wolfgangfriedrich/P42Display/Design/ver3/P42_Display_Shield_rev3_SCH.png

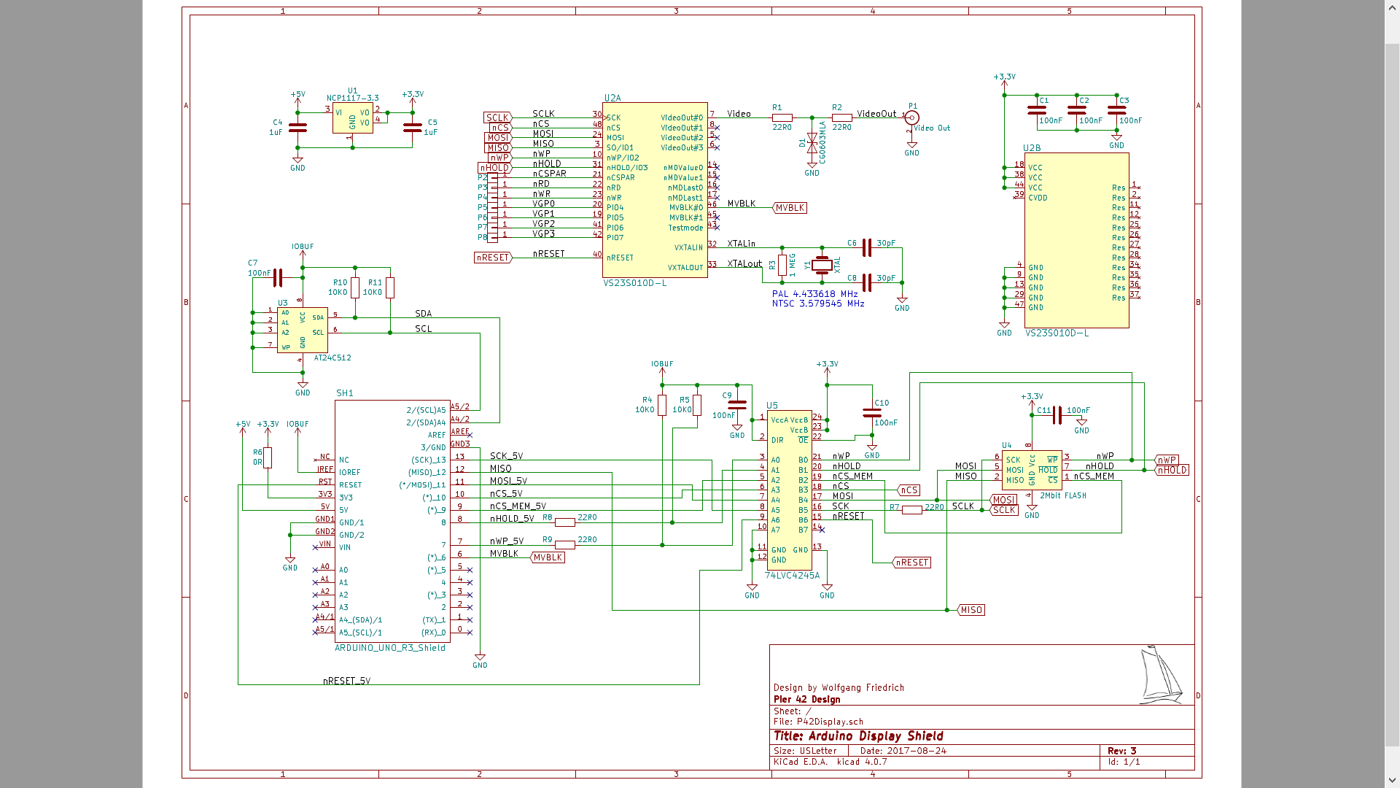
Design/ver3/P42_Display_Shield_rev3_SCH.png
