wolfgangfriedrich/P42Display/Design/ver3/P42Display_rev3_Assembly.xlsx

Name: |  | P42Ddisplay | Rev 3
Date: |  | 2017-11-07 20:05
Tool: |  | Eeschema 4.0.7 |  | Elecrow free components
 |  |  |  | Do not quote/populate
Component Count: |  |  | 30
Collated Components:
Item | Qty | Reference(s) | Value | Footprint | BOM Description | BOM2 | Mfr1 | Mfr1PN | Mfr2 | Mfr2PN | Note
1 | 7 | C1, C2, C3, C7, C9, C10, C11 | 100nF | Capacitors_SMD:C_0603 | Cap, 100nF, +10%, X7R, 0603 |  | generic | na
2 | 2 | C4, C5 | 1uF | Capacitors_SMD:C_0603 | Cap, 1uF, +10%, X7R, 0603 |  | generic | na
3 | 2 | C6, C8 | 30pF | Capacitors_SMD:C_0603 | Cap Cer, 30pF, +10%, NP0, 0603 |  | generic | na
4 | 1 | D1 | CG0603MLA | Capacitors_SMD:C_0603 | Diode TVS 8V 30A 0603 |  | Bourns | CG0603MLA-5.5ME
5 | 1 | P1 | Video Out | project:CUI_RCJ-01x | CONN RCA JACK MONO 3.2MM R/A |  | CUI | RCJ-014
13 | 5 | R1, R2, R7, R8, R9 | 22R0 | Resistors_SMD:R_0603 | RES, 22R0, 1%, 0.1W, 0603
14 | 1 | R3 | 1 MEG | Resistors_SMD:R_0603 | RES, 1MEG, 1%, 0.125W, 0603
15 | 4 | R4, R5, R10, R11 | 10K0 | Resistors_SMD:R_0603 | RES, 10K0, 1%, 0.1W, 0603
16 | 1 | R6 | 0R | Resistors_SMD:R_0603 | RES, 0R0, 1A, 0603
18 | 1 | U1 | NCP1117-3.3 | TO_SOT_Packages_SMD:SOT-223 | IC REG LDO 3.3V 1A SOT223 |  | Diodes Inc | AZ1117EH-3.3TRG1
19 | 1 | U2 | VS23S010D-L | Housings_QFP:LQFP-48_7x7mm_Pitch0.5mm | IC SPI PARALLEL MEM+VIDEO OUT, TQFP-48 |  | VLSI | VS23S010D-L
20 | 1 | U3 | AT24C512 | SMD_Packages:SOIC-8-N | IC, Memory, I2C, 512Kbit, SO-08 |  | Atmel | AT24CS64-SSHM
21 | 1 | U4 | 2Mbit FLASH | SMD_Packages:SOIC-8-N | IC FLASH 2MBIT 8SOIC |  | Winbond | W25X20CLSNIG
22 | 1 | U5 | 74LVC4245A | Housings_SSOP:TSSOP-24_4.4x7.8mm_Pitch0.65mm | IC TRANSCVR TRI-ST DL 24TSSOP |  | Nexperia | 74LVC4245APW
23 | 1 | Y1 | XTAL | Crystals:Crystal_SMD_HC49-SD | CRYSTAL 3.579545MHZ 18PF NTSC HC-49-SMD | CRYSTAL 4.433619MHZ 18PF PAL HC49-SMD | Abracon | ABLS-3.579545MHZ-D-4-T | Abracon | ABLS-4.433619MHZ-B4-T | PAL
 | 30
