wolfgangfriedrich/P42Display/Design/ver3/P42Display_rev3_ASSY.pdf

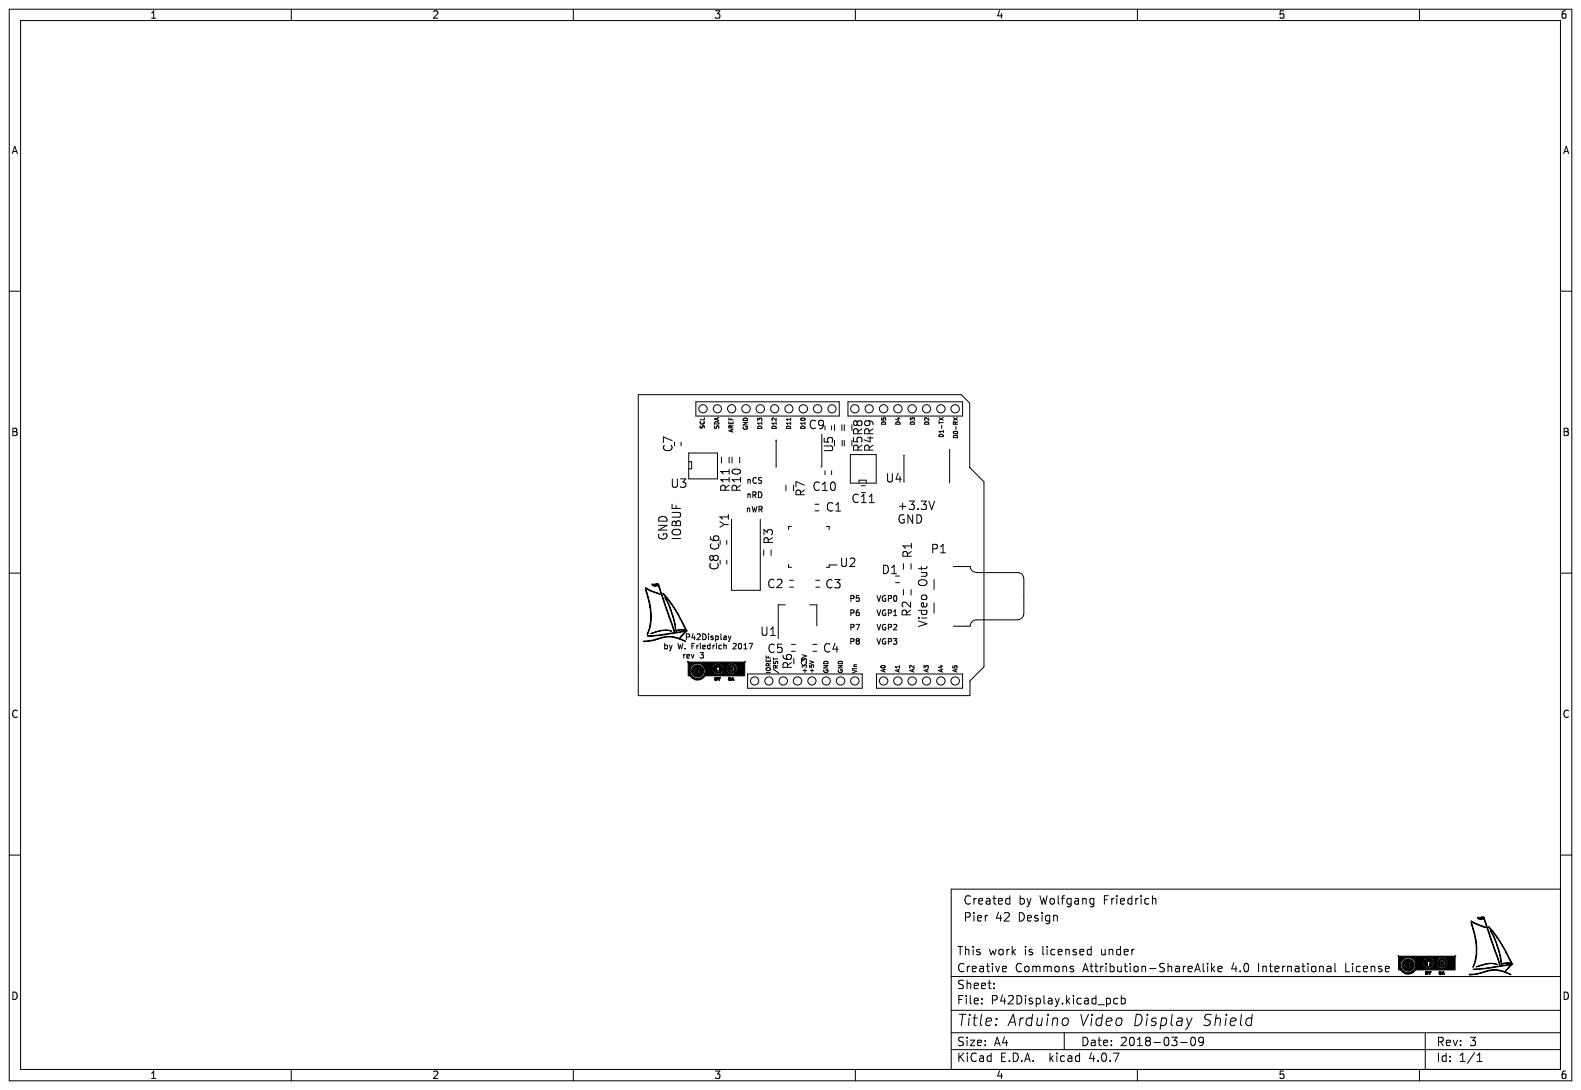
[picture p10: page 1]
