wolfgangfriedrich/P42Display/Design/ver3/P42Display_rev3_SCH.pdf

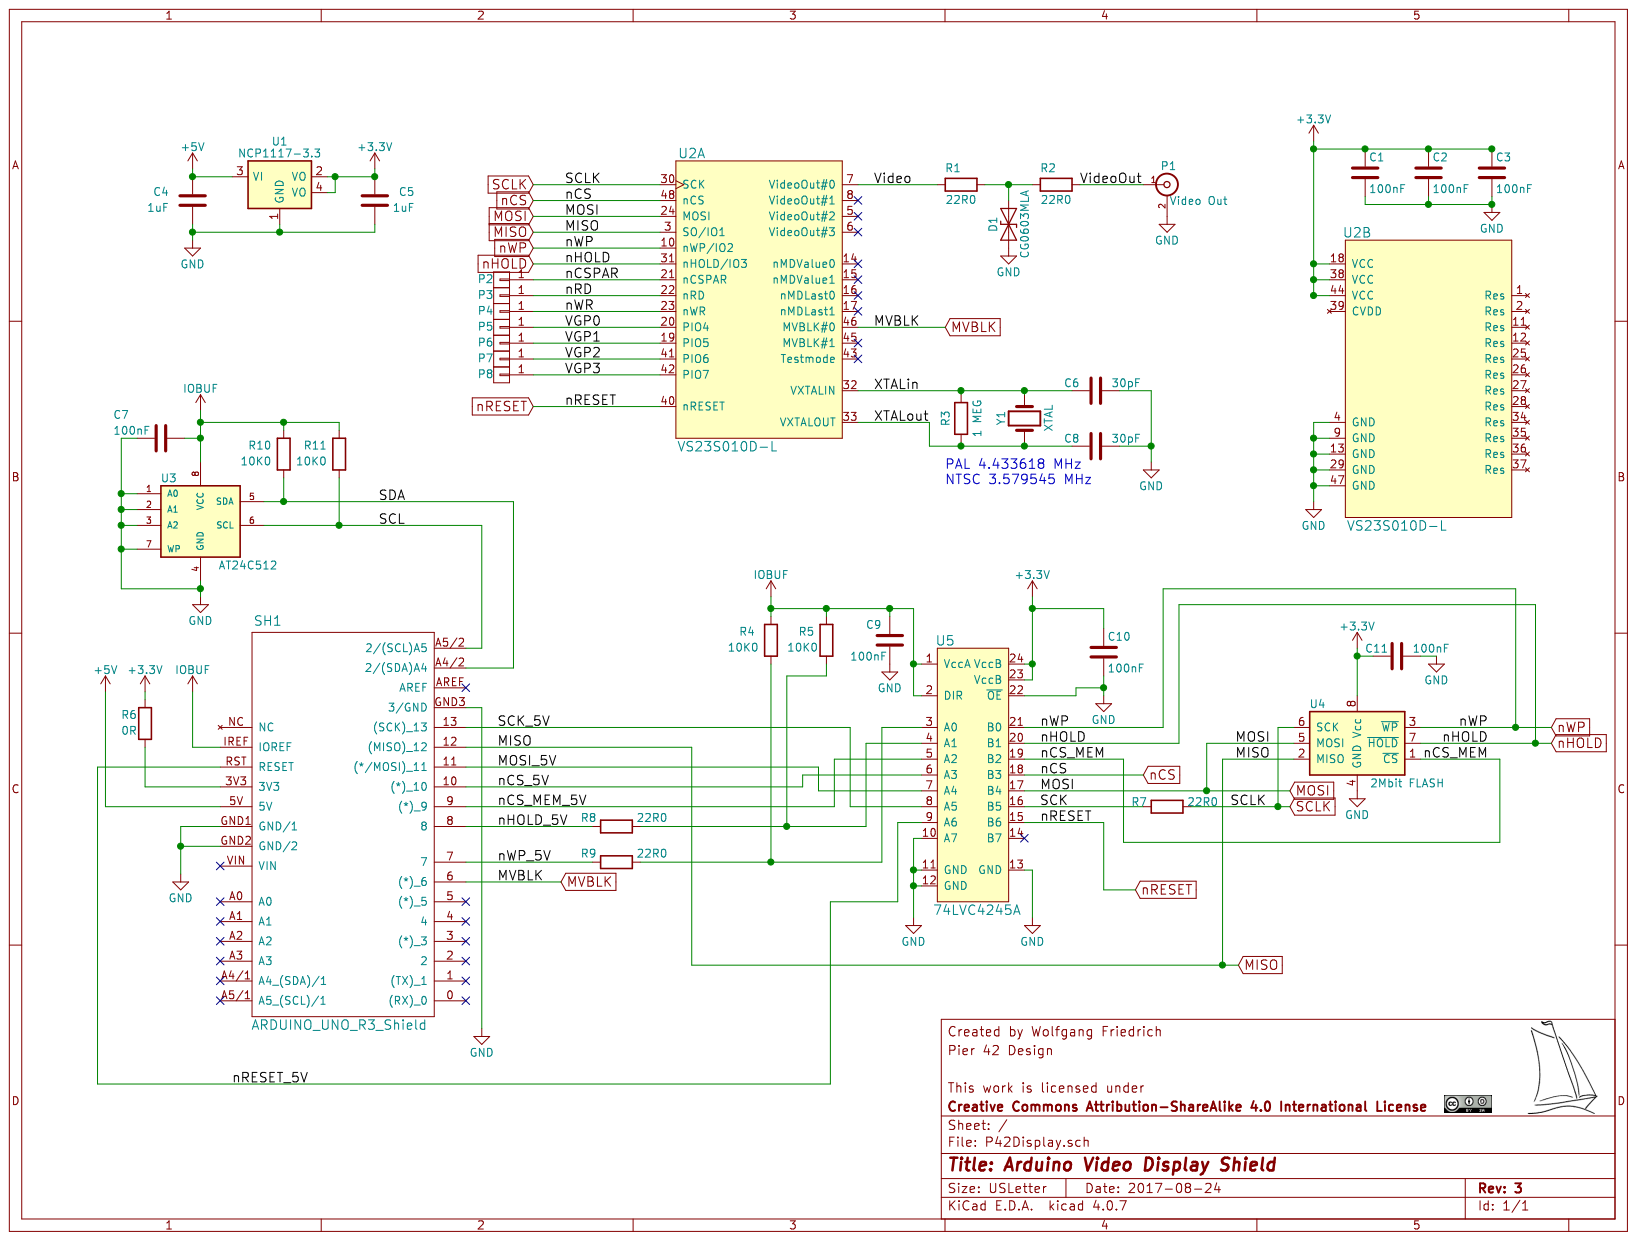
[picture p11: page 1]
