wolfgangfriedrich/P42Display/Design/ver1/P42Display_rev1_sch.pdf

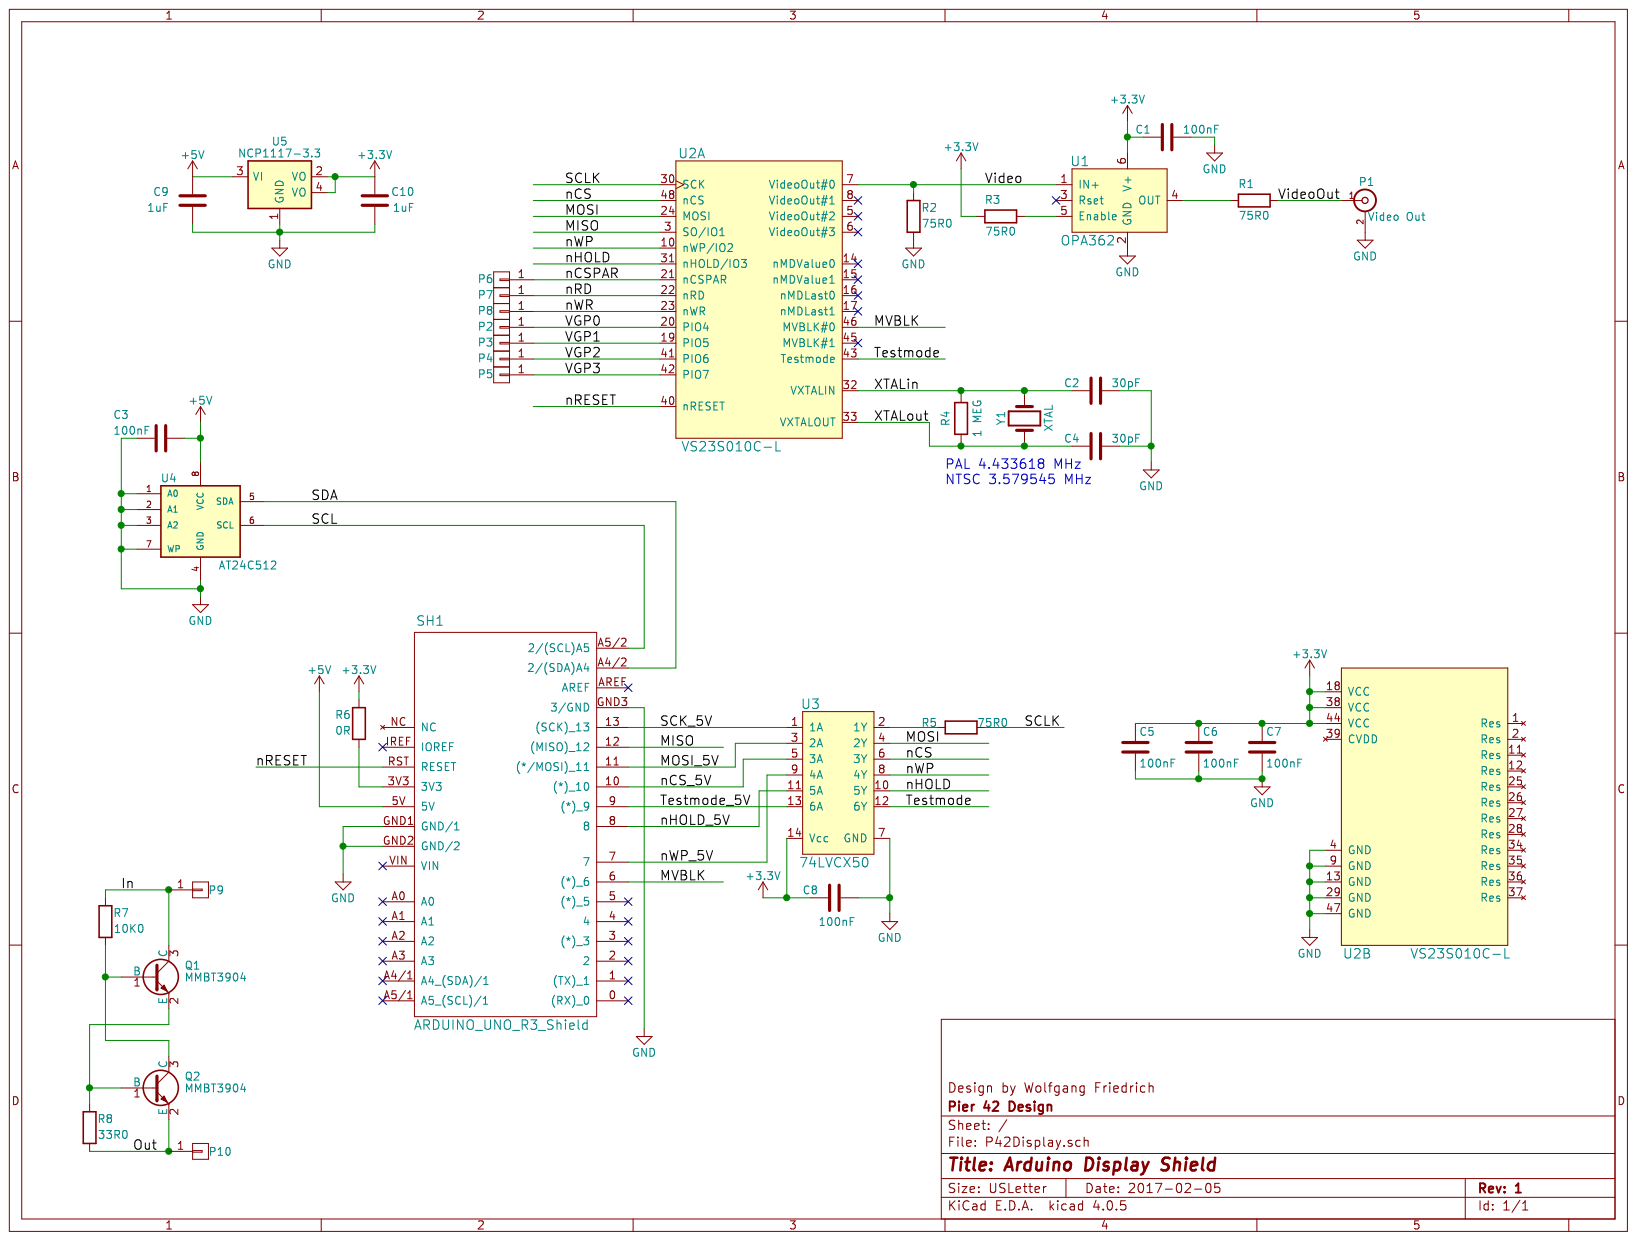
[picture p12: page 1]
