wolfgangfriedrich/P42Display/Design/ver3/P42Display.kicad_pcb

## KiCad design Design/ver3/P42Display.kicad_pcb (2018-03-10)

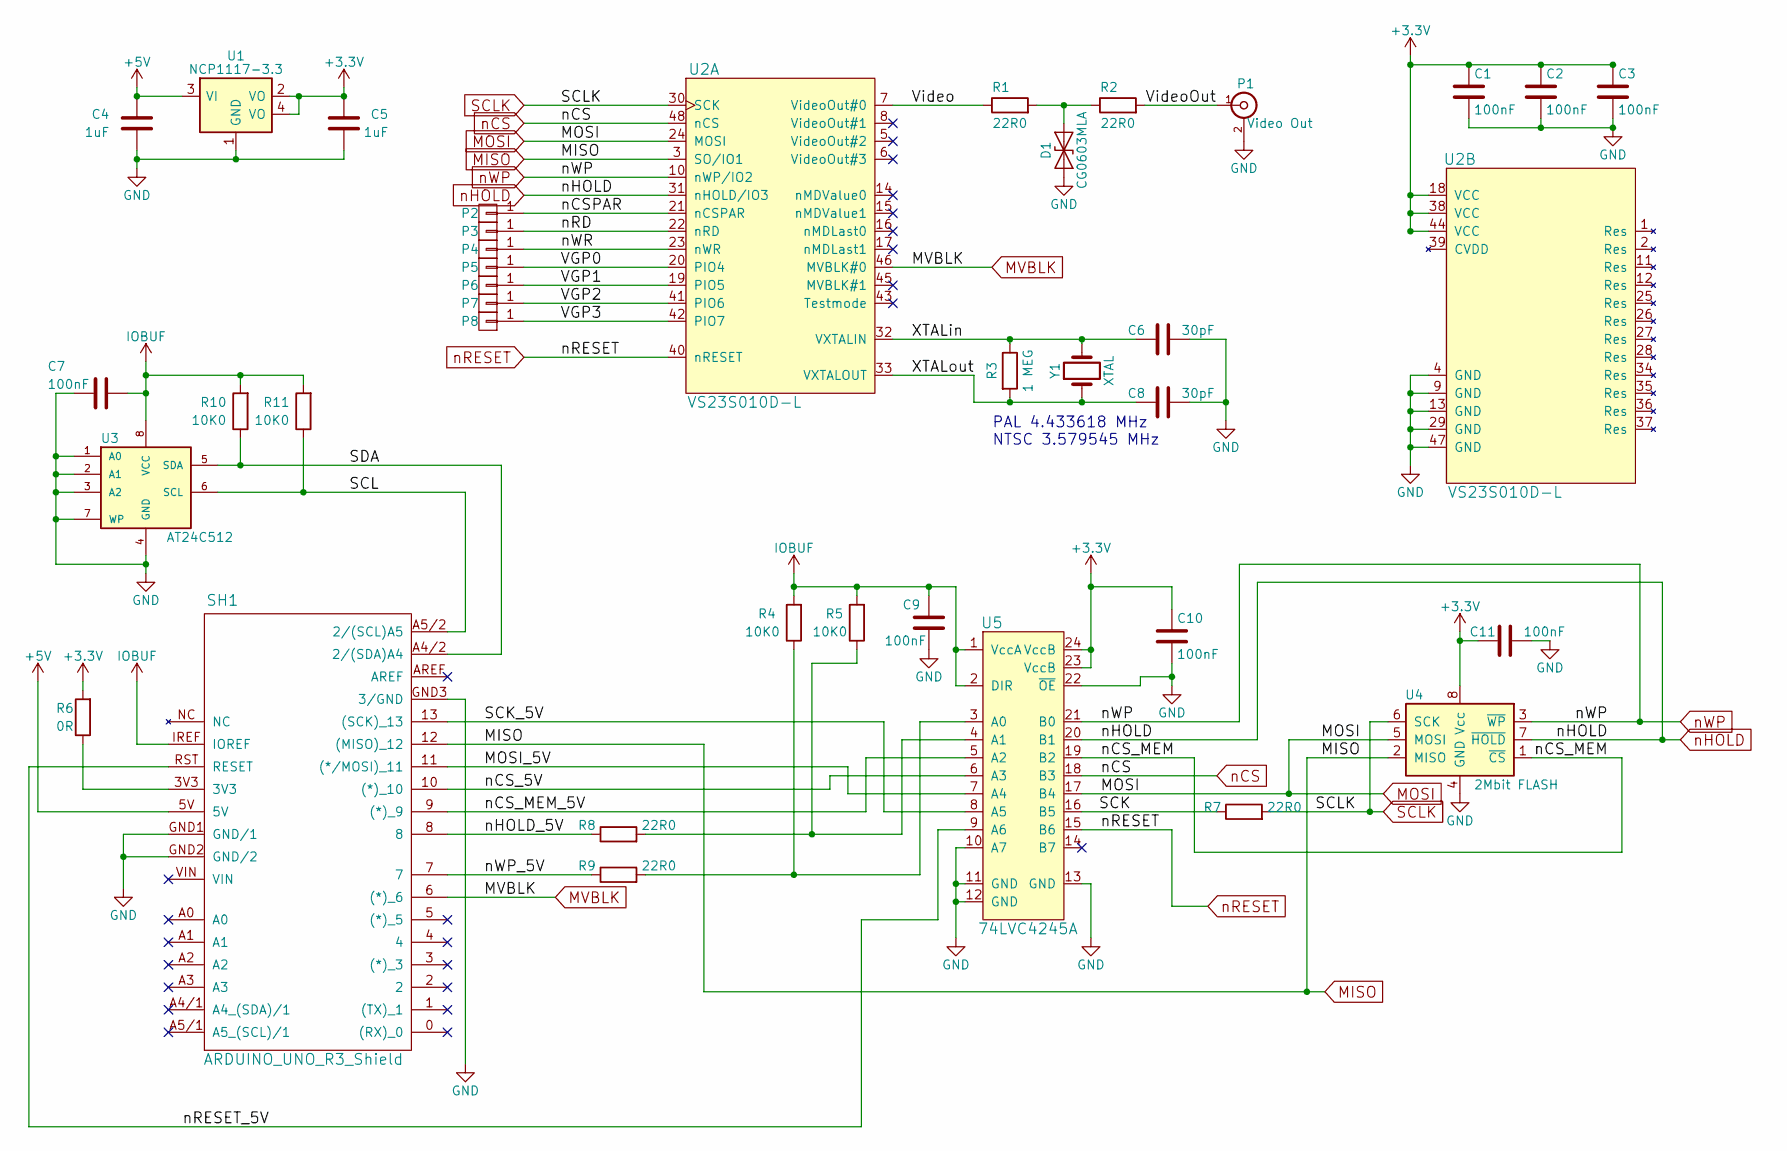
[picture p13: schematic P42Display.sch, Arduino Video Display Shield]

Parts:
C1, C2, C3, C7, C9, C10, C11: 100nF; C_0603; Mfr1PN na
C4, C5: 1uF; C_0603; Mfr1PN na
C6, C8: 30pF; C_0603; Mfr1PN na
D1: CG0603MLA; C_0603; Mfr1PN CG0603MLA-5.5ME
P1: Video Out; CUI_RCJ-01x; Mfr1PN RCJ-014
P2: nCS; Measurement_Point_Round-TH_Small
P3: nRD; Measurement_Point_Round-TH_Small
P4: nWR; Measurement_Point_Round-TH_Small
P5: VGP0; Measurement_Point_Round-TH_Small
P6: VGP1; Measurement_Point_Round-TH_Small
P7: VGP2; Measurement_Point_Round-TH_Small
P8: VGP3; Measurement_Point_Round-TH_Small
R1, R2, R7, R8, R9: 22R0; R_0603
R3: 1 MEG; R_0603
R4, R5, R10, R11: 10K0; R_0603
R6: 0R; R_0603
SH1: ARDUINO_UNO_R3_Shield; ARDUINO_as_UNO_R3_CONTOUR
U1: NCP1117-3.3; SOT-223; Mfr1PN AZ1117EH-3.3TRG1
U2: VS23S010D-L; LQFP-48_7x7mm_Pitch0.5mm; Mfr1PN VS23S010D-L
U3: AT24C512; SOIC-8-N; Mfr1PN AT24CS64-SSHM
U4: 2Mbit FLASH; SOIC-8-N; Mfr1PN W25X20CLSNIG
U5: 74LVC4245A; TSSOP-24_4.4x7.8mm_Pitch0.65mm; Mfr1PN 74LVC4245APW
Y1: XTAL; Crystal_SMD_HC49-SD; Mfr1PN ABLS-3.579545MHZ-D-4-T

Connections:
+3V3: C1.1, C2.1, C3.1, C5.2, C10.1, C11.2, R6.2, U1.2 (VO), U1.4 (VO), U2.18 (VCC), U2.38 (VCC), U2.44 (VCC), U4.8 (Vcc), U5.23 (VccB), U5.24 (VccB)
+5V: C4.2, SH1.5V, U1.3 (VI)
/MOSI_5V: SH1.11 ((*/MOSI)_11), U5.7 (A4)
/SCK: R7.1, U5.16 (B5)
/SCK_5V: SH1.13 ((SCK)_13), U5.8 (A5)
/SCL: R11.1, SH1.A5/2 (2/(SCL)A5), U3.6 (SCL)
/SDA: R10.1, SH1.A4/2 (2/(SDA)A4), U3.5 (SDA)
/VGP0: P5.1, U2.20 (PIO4)
/VGP1: P6.1, U2.19 (PIO5)
/VGP2: P7.1, U2.41 (PIO6)
/VGP3: P8.1, U2.42 (PIO7)
/Video: R1.1, U2.7 (VideoOut#0)
/VideoOut: P1.1 (In), R2.2
/XTALin: C6.2, R3.1, U2.32 (VXTALIN), Y1.2
/XTALout: C8.2, R3.2, U2.33 (VXTALOUT), Y1.1
/nCSPAR: P2.1, U2.21 (nCSPAR)
/nCS_5V: SH1.10 ((*)_10), U5.6 (A3)
/nCS_MEM: U4.1 (~CS), U5.19 (B2)
/nCS_MEM_5V: SH1.9 ((*)_9), U5.5 (A2)
/nHOLD_5V: R8.1, SH1.8
/nRD: P3.1, U2.22 (nRD)
/nRESET_5V: SH1.RST (RESET), U5.9 (A6)
/nWP_5V: R9.1, SH1.7
/nWR: P4.1, U2.23 (nWR)
GND: C1.2, C2.2, C3.2, C4.1, C5.1, C6.1, C7.2, C8.1, C9.2, C10.2, C11.1, D1.1 (A1), P1.2 (Ext), SH1.GND1 (GND/1), SH1.GND2 (GND/2), SH1.GND3 (3/GND), U1.1 (GND), U2.4 (GND), U2.9 (GND), U2.13 (GND), U2.29 (GND), U2.47 (GND), U3.1 (A0), U3.2 (A1), U3.3 (A2), U3.4 (GND), U3.7 (WP), U4.4 (GND), U5.10 (A7), U5.11 (GND), U5.12 (GND), U5.13 (GND), U5.22 (~OE)
IOBUF: C7.1, C9.1, R4.2, R5.2, R10.2, R11.2, SH1.IREF (IOREF), U3.8 (VCC), U5.1 (VccA), U5.2 (DIR)
MISO: SH1.12 ((MISO)_12), U2.3 (SO/IO1), U4.2 (MISO)
MOSI: U2.24 (MOSI), U4.5 (MOSI), U5.17 (B4)
MVBLK: SH1.6 ((*)_6), U2.46 (MVBLK#0)
unnamed: D1.2 (A2), R1.2, R2.1
unnamed: R4.1, R9.2, U5.3 (A0)
unnamed: R5.1, R8.2, U5.4 (A1)
unnamed: R6.1, SH1.3V3
SCLK: R7.2, U2.30 (SCK), U4.6 (SCK)
nCS: U2.48 (nCS), U5.18 (B3)
nHOLD: U2.31 (nHOLD/IO3), U4.7 (~HOLD), U5.20 (B1)
nRESET: U2.40 (nRESET), U5.15 (B6)
nWP: U2.10 (nWP/IO2), U4.3 (~WP), U5.21 (B0)

Notes on the sheet:
PAL 4.433618 MHz NTSC 3.579545 MHz

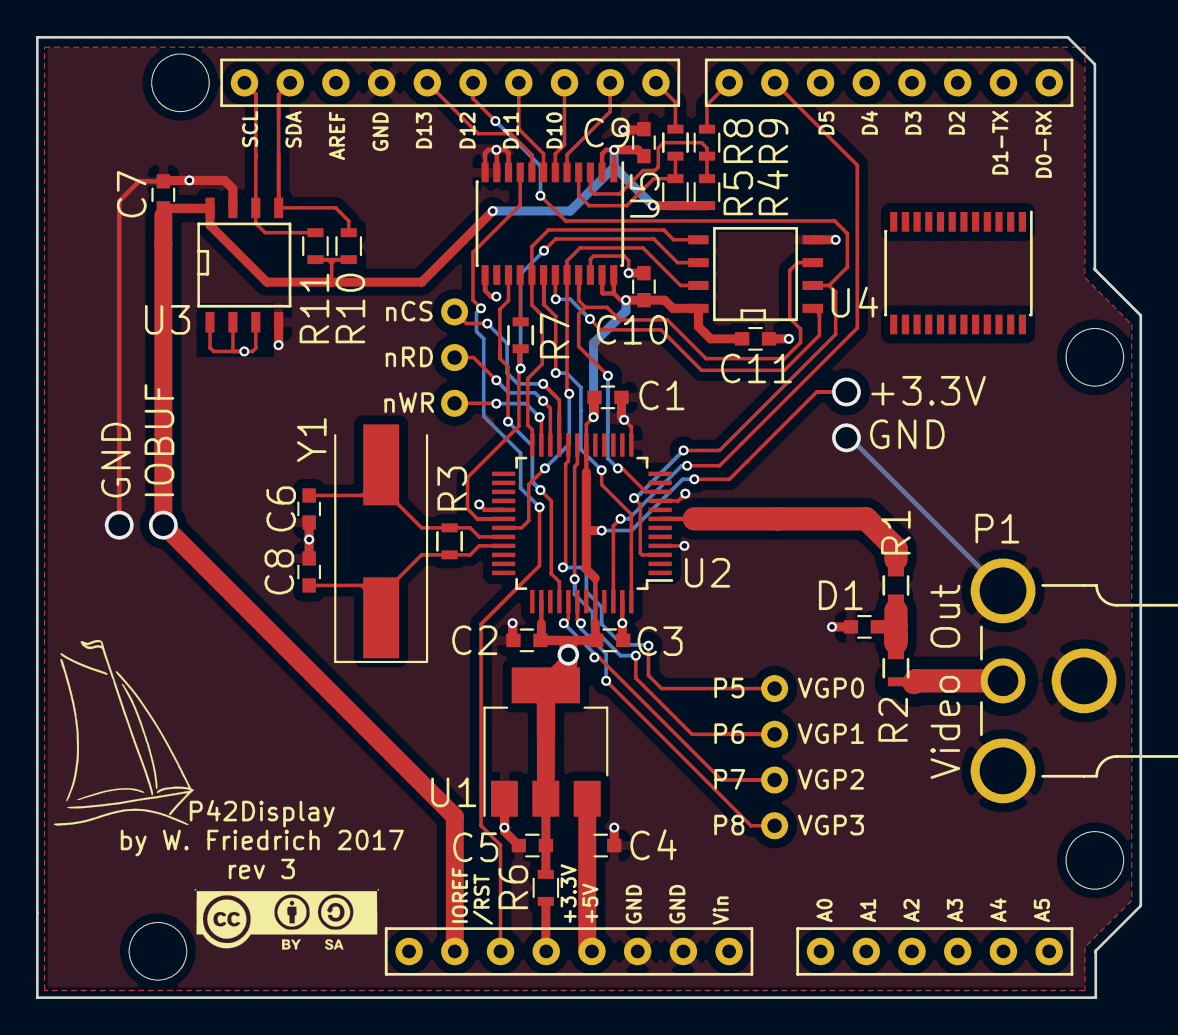
[picture p14: board P42Display.kicad_pcb from above]

Board: 2 copper layers, 61.3 x 53.3 mm, 38 parts (0 on the bottom side), 38 nets.
