wolfgangfriedrich/P42Display/Code/P42_charmem/hack8x8.h

// 
//  Font data for Hack 8pt
// 

// Character bitmaps for Hack 8pt
const byte hack_8ptBitmaps[] = 
{
	// @0 '!' (2 pixels wide)
	0x00, //   
	0x40, //  #
	0x40, //  #
	0x40, //  #
	0x40, //  #
	0x00, //   
	0xC0, // ##
	0x00, //   

	// @12 '"' (3 pixels wide)
	0x00, //    
	0xA0, // # #
	0xA0, // # #
	0x00, //    
	0x00, //    
	0x00, //    
	0x00, //    
	0x00, //    

	// @24 '#' (7 pixels wide)
	0x24, //   #  # 
	0x7E, //  ######
	0x28, //   # #  
	0x28, //   # #  
	0xFC, // ###### 
	0x50, //  # #   
	0x50, //  # #   
	0x00, //        

	// @36 '$' (5 pixels wide)
	0x20, //   #  
	0x70, //  ### 
	0xA0, // # #  
	0x70, //  ### 
	0x28, //   # #
	0xF0, // #### 
	0x20, //   #  
	0x00, //      

	// @48 '%' (6 pixels wide)
	0x00, //      
	0x60, //  ##   
	0x94, // #  # #
	0x78, //  #### 
	0x6C, //  ## ##
	0x94, // #  # #
	0x0C, //     ##
	0x00, //       

	// @60 '&' (7 pixels wide)
	0x38, //   ###  
	0x40, //  #     
	0x60, //  ##    
	0x52, //  # #  #
	0x8C, // #   ## 
	0xCC, // ##  ## 
	0x76, //  ### ##
	0x00, //        

	// @72 ''' (1 pixels wide)
	0x00, //  
	0x80, // #
	0x80, // #
	0x00, //  
	0x00, //  
	0x00, //  
	0x00, //  
	0x00, //  

	// @84 '(' (2 pixels wide)
	0x00, //   
	0x40, //  #
	0x80, // # 
	0x80, // # 
	0x80, // # 
	0x80, // # 
	0x80, // # 
	0x40, //  #

	// @96 ')' (2 pixels wide)
	0x00, //   
	0x80, // # 
	0x40, //  # 
	0x40, //  #
	0x40, //  #
	0x40, //  #
	0x40, //  # 
	0x80, // # 

	// @108 '*' (5 pixels wide)
	0x00, //      
	0x20, //   #  
	0xA8, // # # #
	0x70, //  ### 
	0xA8, // # # #
	0x20, //   #  
	0x00, //      
	0x00, //      

	// @120 '+' (6 pixels wide)
	0x00, //       
	0x10, //    #  
	0x10, //    #  
	0x7C, //  #####
	0x10, //    #  
	0x10, //    #  
	0x00, //       
	0x00, //       

	// @132 ',' (2 pixels wide)
	0x00, //   
	0x00, //   
	0x00, //   
	0x00, //   
	0x00, //   
	0x40, //  #
	0x40, //  #
	0xC0, // ##

	// @144 '-' (5 pixels wide)
	0x00, //      
	0x00, //      
	0x00, //      
	0x00, //      
	0xF8, // #####
	0x00, //      
	0x00, //      
	0x00, //      

	// @156 '.' (2 pixels wide)
	0x00, //   
	0x00, //   
	0x00, //   
	0x00, //   
	0x00, //   
	0x40, //  #
	0xC0, // ##
	0x00, //   

	// @168 '/' (5 pixels wide)
	0x08, //     #
	0x10, //    # 
	0x10, //    # 
	0x20, //   #  
	0x20, //   #  
	0x40, //  #   
	0x40, //  #   
	0x80, // #    

	// @180 '0' (5 pixels wide)
	0x00, //      
	0x70, //  ### 
	0x98, // #  ##
	0xA8, // # # #
	0xA8, // # # #
	0xC8, // ##  #
	0x70, //  ### 
	0x00, //      

	// @192 '1' (5 pixels wide)
	0x00, //      
	0xE0, // ###  
	0x20, //   #  
	0x20, //   #  
	0x20, //   #  
	0x20, //   #  
	0xF8, // #####
	0x00, //      

	// @204 '2' (5 pixels wide)
	0x00, //      
	0x70, //  ### 
	0x88, // #   #
	0x10, //    # 
	0x60, //  ##  
	0x80, // #    
	0xF8, // #####
	0x00, //      

	// @216 '3' (5 pixels wide)
	0x00, //      
	0xF0, // #### 
	0x18, //    ##
	0x60, //  ##  
	0x18, //    ##
	0x08, //     #
	0xF0, // #### 
	0x00, //      

	// @228 '4' (5 pixels wide)
	0x00, //      
	0x10, //    # 
	0x30, //   ## 
	0x50, //  # # 
	0x90, // #  # 
	0xF8, // #####
	0x10, //    # 
	0x00, //      

	// @240 '5' (5 pixels wide)
	0x00, //      
	0xF0, // #### 
	0x80, // #    
	0xF0, // #### 
	0x08, //     #
	0x08, //     #
	0xF0, // #### 
	0x00, //      

	// @252 '6' (5 pixels wide)
	0x00, //      
	0x70, //  ### 
	0x80, // #    
	0xF0, // #### 
	0x88, // #   #
	0x88, // #   #
	0x70, //  ### 
	0x00, //      

	// @264 '7' (5 pixels wide)
	0x00, //      
	0xF8, // #####
	0x10, //    # 
	0x10, //    # 
	0x20, //   #  
	0x40, //  #   
	0x40, //  #   
	0x00, //      

	// @276 '8' (5 pixels wide)
	0x00, //      
	0x70, //  ### 
	0x88, // #   #
	0x70, //  ### 
	0x88, // #   #
	0x88, // #   #
	0x70, //  ### 
	0x00, //      

	// @288 '9' (5 pixels wide)
	0x00, //      
	0x70, //  ### 
	0x88, // #   #
	0x98, // #  ##
	0x68, //  ## #
	0x08, //     #
	0xF0, // #### 
	0x00, //      

	// @300 ':' (2 pixels wide)
	0x00, //   
	0x00, //   
	0xC0, // ##
	0x40, //  #
	0x00, //   
	0xC0, // ##
	0x40, //  #
	0x00, //   

	// @312 ';' (2 pixels wide)
	0x00, //   
	0x00, //   
	0x40, //  #
	0xC0, // ##
	0x00, //   
	0x40, //  #
	0x40, //  #
	0xC0, // ##

	// @324 '<' (6 pixels wide)
	0x00, //       
	0x00, //       
	0x0C, //     ##
	0x30, //   ##  
	0xC0, // ##    
	0x30, //   ##  
	0x0C, //     ##
	0x00, //       

	// @336 '=' (6 pixels wide)
	0x00, //       
	0x00, //       
	0x00, //       
	0xFC, // ######
	0x00, //       
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
	0xE0, // ###  
	0x20, //   #  
	0x20, //   #  
	0x18, //    ##
	0x20, //   #  
	0x20, //   #  
	0x20, //   #  
	0xE0, // ###  

	// @1116 '~' (6 pixels wide)
	0x00, //       
	0x00, //       
	0x00, //       
	0x24, //   #  #
	0x54, //  # # #
	0x88, // #   #
	0x00, //       
	0x00, //       
};
