wolfgangfriedrich/P42Display/Code/P42Display_Memtest/ball_frames.h

// Image data for spinning Amiga Ball Demo
// red   0x24
// white 0x0D
// black 0x00
const static byte boingball_X PROGMEM = 32;
const static byte boingball_Y PROGMEM = 32;
const static byte boingball[] PROGMEM = 
{
// frame 0
0x00, 0x00, 0x00, 0x00, 0x00, 0x00, 0x00, 0x00, 0x00, 0x00, 0x00, 0x00, 0x00, 0x00, 0x00, 0x00, 0x00, 0x00, 0x00, 0x00, 0x00, 0x00, 0x00, 0x00, 0x00, 0x00, 0x00, 0x00, 0x00, 0x00, 0x00, 0x00, 
0x00, 0x00, 0x00, 0x00, 0x00, 0x00, 0x00, 0x00, 0x00, 0x00, 0x00, 0x24, 0x24, 0x0D, 0x0D, 0x0D, 0x0D, 0x24, 0x24, 0x24, 0x24, 0x0D, 0x00, 0x00, 0x00, 0x00, 0x00, 0x00, 0x00, 0x00, 0x00, 0x00, 
0x00, 0x00, 0x00, 0x00, 0x00, 0x00, 0x00, 0x00, 0x24, 0x0D, 0x0D, 0x0D, 0x24, 0x24, 0x24, 0x24, 0x24, 0x0D, 0x24, 0x24, 0x24, 0x24, 0x0D, 0x0D, 0x00, 0x00, 0x00, 0x00, 0x00, 0x00, 0x00, 0x00, 
0x00, 0x00, 0x00, 0x00, 0x00, 0x00, 0x00, 0x0D, 0x0D, 0x0D, 0x0D, 0x24, 0x24, 0x24, 0x24, 0x24, 0x0D, 0x0D, 0x0D, 0x0D, 0x0D, 0x0D, 0x0D, 0x0D, 0x0D, 0x24, 0x00, 0x00, 0x00, 0x00, 0x00, 0x00, 
0x00, 0x00, 0x00, 0x00, 0x00, 0x00, 0x0D, 0x0D, 0x0D, 0x0D, 0x24, 0x24, 0x24, 0x24, 0x24, 0x24, 0x0D, 0x0D, 0x0D, 0x0D, 0x0D, 0x0D, 0x24, 0x24, 0x24, 0x0D, 0x24, 0x00, 0x00, 0x00, 0x00, 0x00, 
0x00, 0x00, 0x00, 0x00, 0x00, 0x0D, 0x0D, 0x0D, 0x0D, 0x24, 0x24, 0x24, 0x24, 0x24, 0x24, 0x0D, 0x0D, 0x0D, 0x0D, 0x0D, 0x0D, 0x0D, 0x24, 0x24, 0x24, 0x24, 0x0D, 0x24, 0x00, 0x00, 0x00, 0x00, 
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
0x00, 0x00, 0x00, 0x00, 0x00, 0x00, 0x00, 0x00, 0x00, 0x00, 0x00, 0x00, 0x00, 0x00, 0x00, 0x00, 0x00, 0x00, 0x00, 0x00, 0x00, 0x00, 0x00, 0x00, 0x00, 0x00, 0x00, 0x00, 0x00, 0x00, 0x00, 0x00, 

};
