wolfgangfriedrich/P42Display/(commit log)

2017-04-17 Arduino Display Shield
    Shield with Framebuffer and analog video output
2018-01-01 SCH rev3 added
    Rev3 with SPI FLASH and IOBUF usage
2018-01-01 Schematics rev 3 added
    Sch rev 3 with SPI FLASH and IOBUF for voltage level shifter
2018-02-18 Added Memtest code
    Arduino program to test I2C EEPROM and SPI Flash. And added font bitmap
    information into Flash.
2018-03-10 Initial files for Tindie sale start
    Rev3 KiCAD files, demo SW and documentation
    [P42Display.kicad_pcb, P42Display.sch, P42Display_rev3_Assembly.xlsx]
2018-03-10 Update with license on board
    [P42Display.kicad_pcb]
2018-03-26 V1.1 update
    Due SPI connector description
2018-03-27 2nd attempt to fix Due/Mega pin connection
    Mega/Due pins and wire colour update
2018-04-05 Delete P42 Arduino Display Shield(rev3) Documentation .pdf
    Fixed name in other file
2019-08-13 Image display
    WIP functionality to store an image in Flash received over UART
    (Memtest). Display image from Flash in Demo. Works with 256 colour BMP
    displayed in grey scale.
2019-11-30 Added doc for Arduino DUE
    Instructions how to plug the shield into a DUE.
