wolfgangfriedrich/P42Display/(notices)

Notices in the files:
Design/ver3/P42Display.sch:
Creative Commons Attribution-ShareAlike 4.0 International License
This work is licensed under
